abbyfinka/FYP-Knitted-EMG/Hardware/Programming PCB/SCH_Prog_2026-05-19.pdf

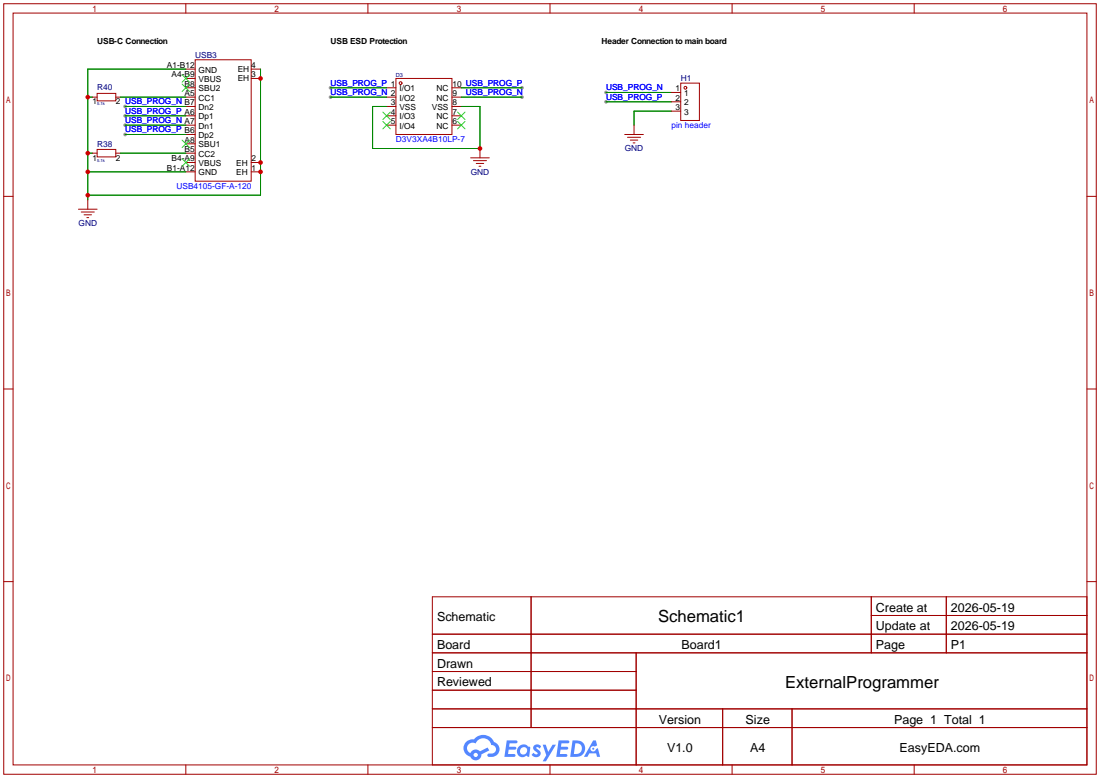
[picture p6: page 1]

Header Connection to main board

Schematic | Schematic1 | Create at | 2026-05-19

Update at | 2026-05-19

Board | Board1 | Page | P1
Drawn | | ExternalProgrammer
Reviewed

Version | Size | Page 1 Total 1
V1.0 | A4 | EasyEDA.com
