abbyfinka/FYP-Knitted-EMG/Hardware/Rigid Redesign/SCH_Schematic1_2026-06-12.pdf

IO48 30 IO35 31 IO36 32 IO37 33 IO38 34 IO39 35 IO40 36 IO41 37 IO42 38 TXD0 39 RXD0 40 IO45 41 GND 42 GND 43 IO46 44 EN 45 GND 46 GND 47 GND 48 GND 49 GND 50 GND 51 GND 52 GND 53 GND 54 GND 55 GND 56 GND 57 GND 58 GND 59 GND 60 GND

# IN1P 16 WCT 64 TESTP_PACE_OUT1 17 RLDOUT 63 TESTN_PACE_OUT2 18

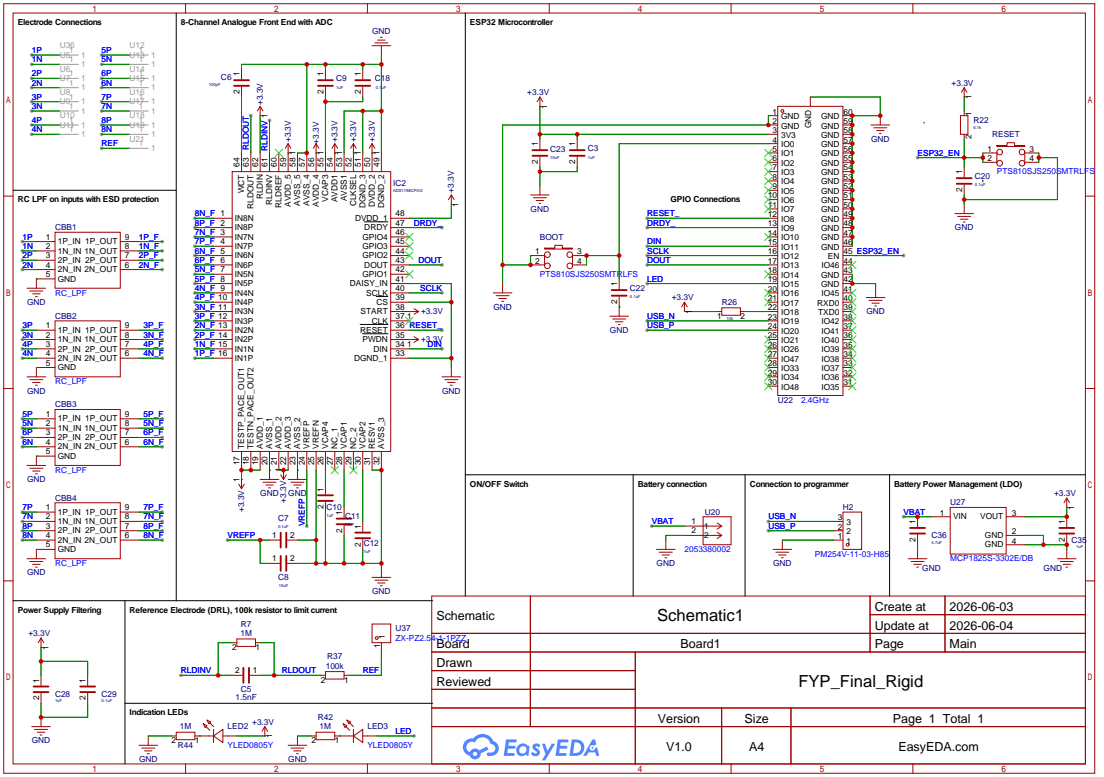
[picture p7: page 1]

8-Channel Analogue Front End with ADC

RC LPF on inputs with ESD protection

Schematic | Schematic1 | Create at | 2026-06-03

Update at | 2026-06-04

Drawn | FYP_Final_Rigid
Reviewed

Version | Size | Page 1 Total 1
V1.0 | A4 | EasyEDA.com

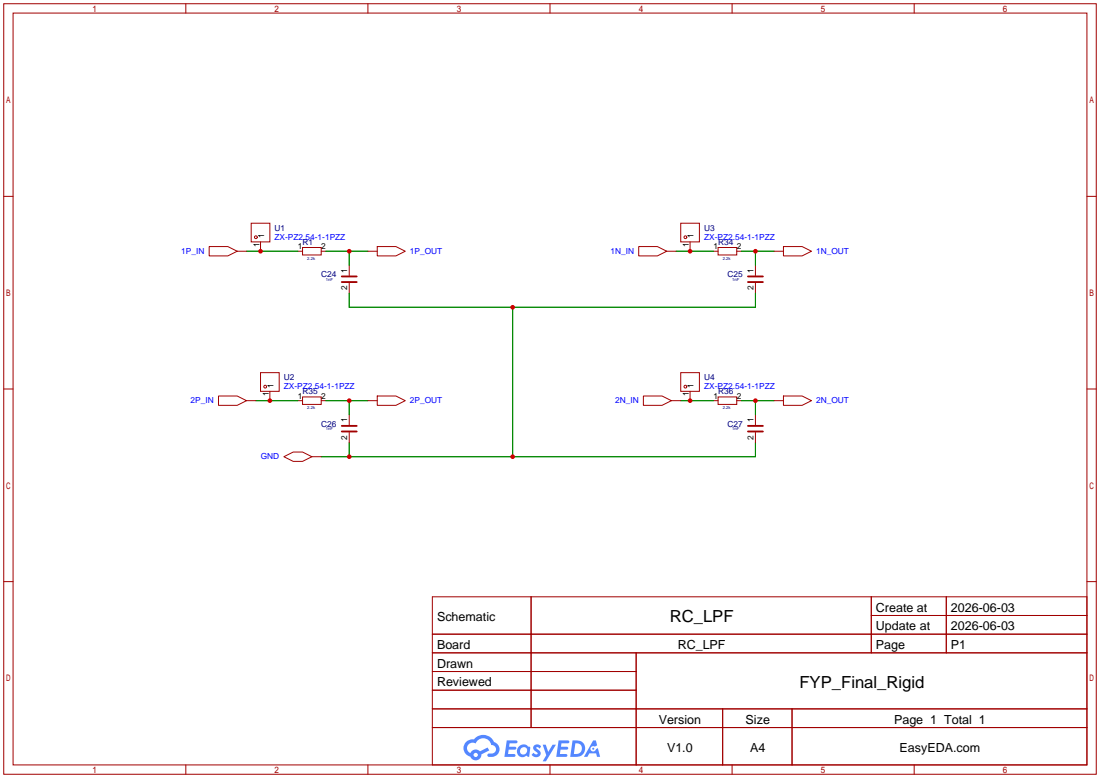
[picture p8: page 2]

Schematic | RC_LPF | Create at | 2026-06-03

Update at | 2026-06-03

Board | RC_LPF | Page | P1
Drawn | | FYP_Final_Rigid
Reviewed

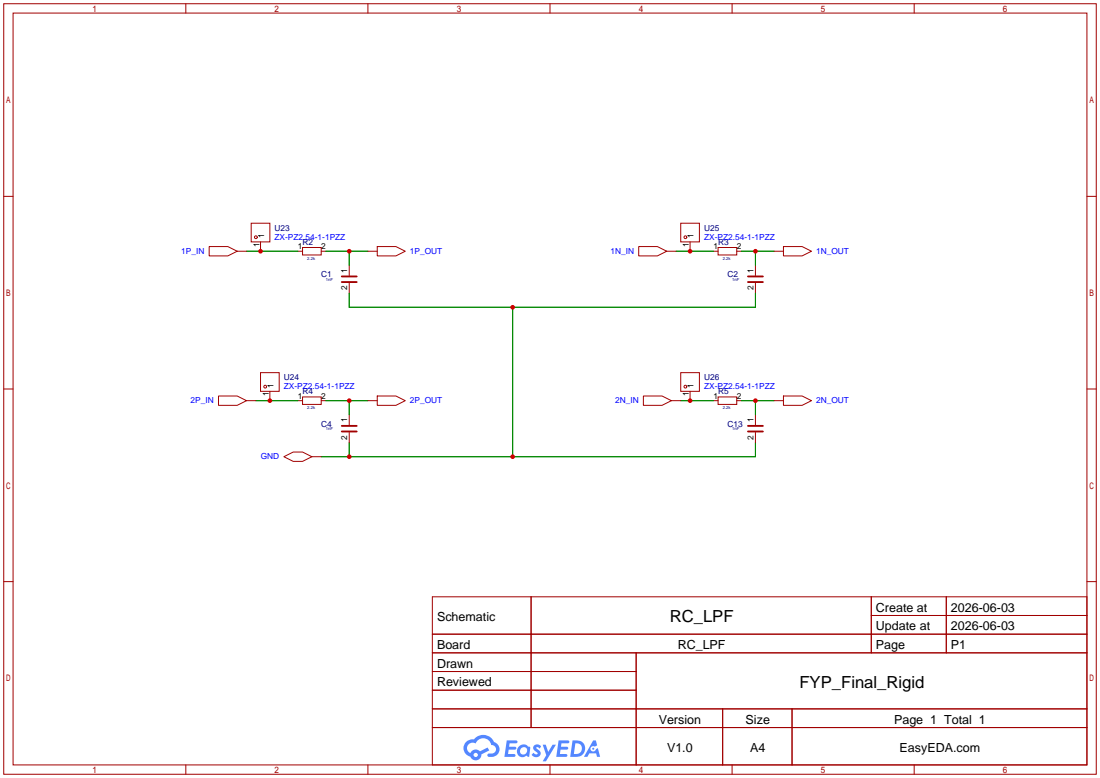
[picture p9: page 3]

Schematic | RC_LPF | Create at | 2026-06-03

Update at | 2026-06-03

Board | RC_LPF | Page | P1
Drawn | | FYP_Final_Rigid
Reviewed

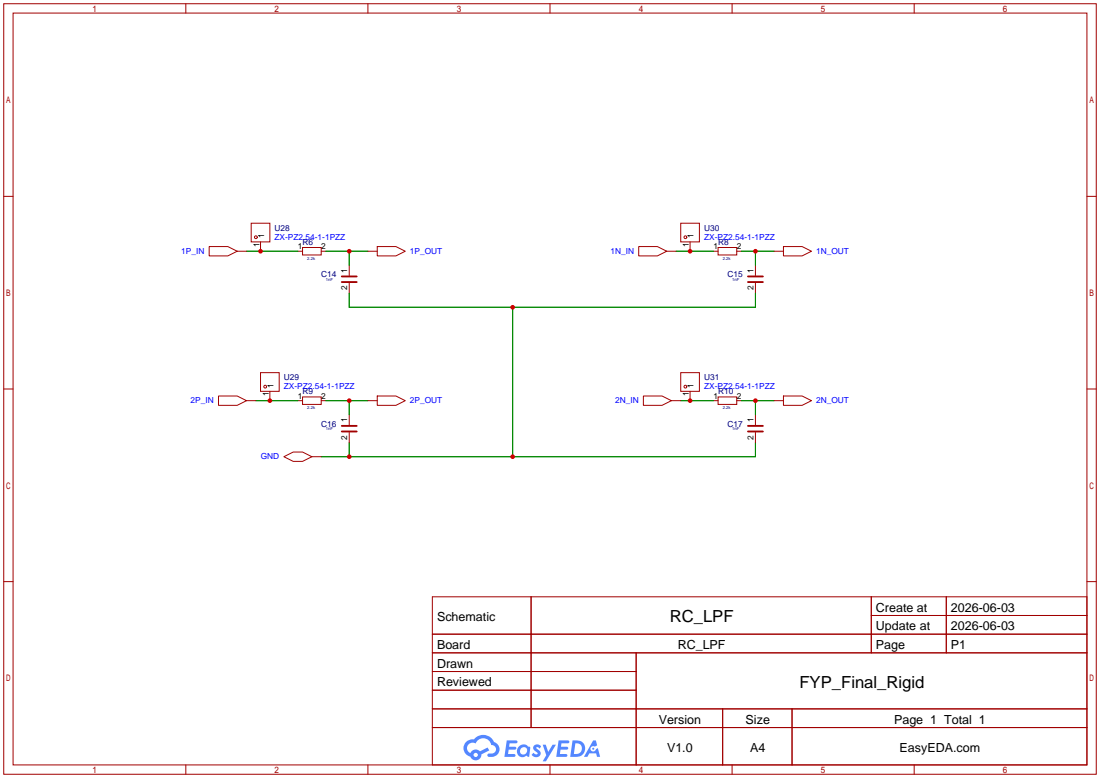
[picture p10: page 4]

Schematic | RC_LPF | Create at | 2026-06-03

Update at | 2026-06-03

Board | RC_LPF | Page | P1
Drawn | | FYP_Final_Rigid
Reviewed

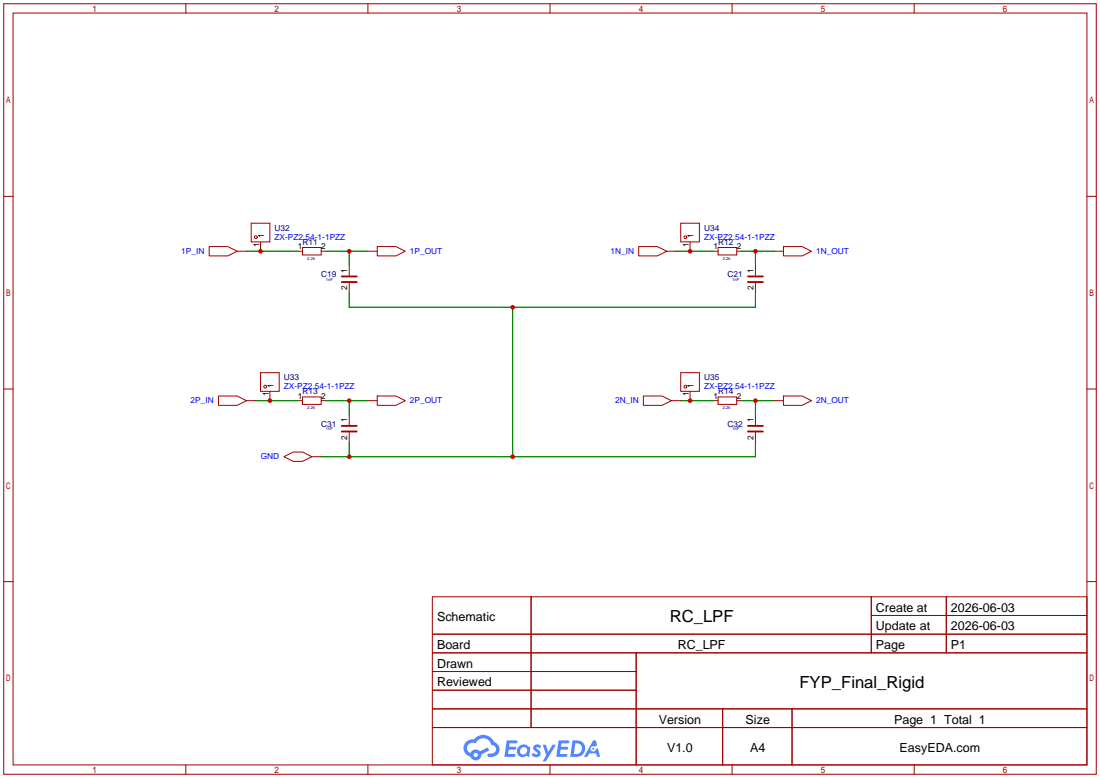
[picture p11: page 5]

Schematic | RC_LPF | Create at | 2026-06-03

Update at | 2026-06-03

Board | RC_LPF | Page | P1
Drawn | | FYP_Final_Rigid
Reviewed
