abbyfinka/FYP-Knitted-EMG/Hardware/Test PCB/schematic.pdf

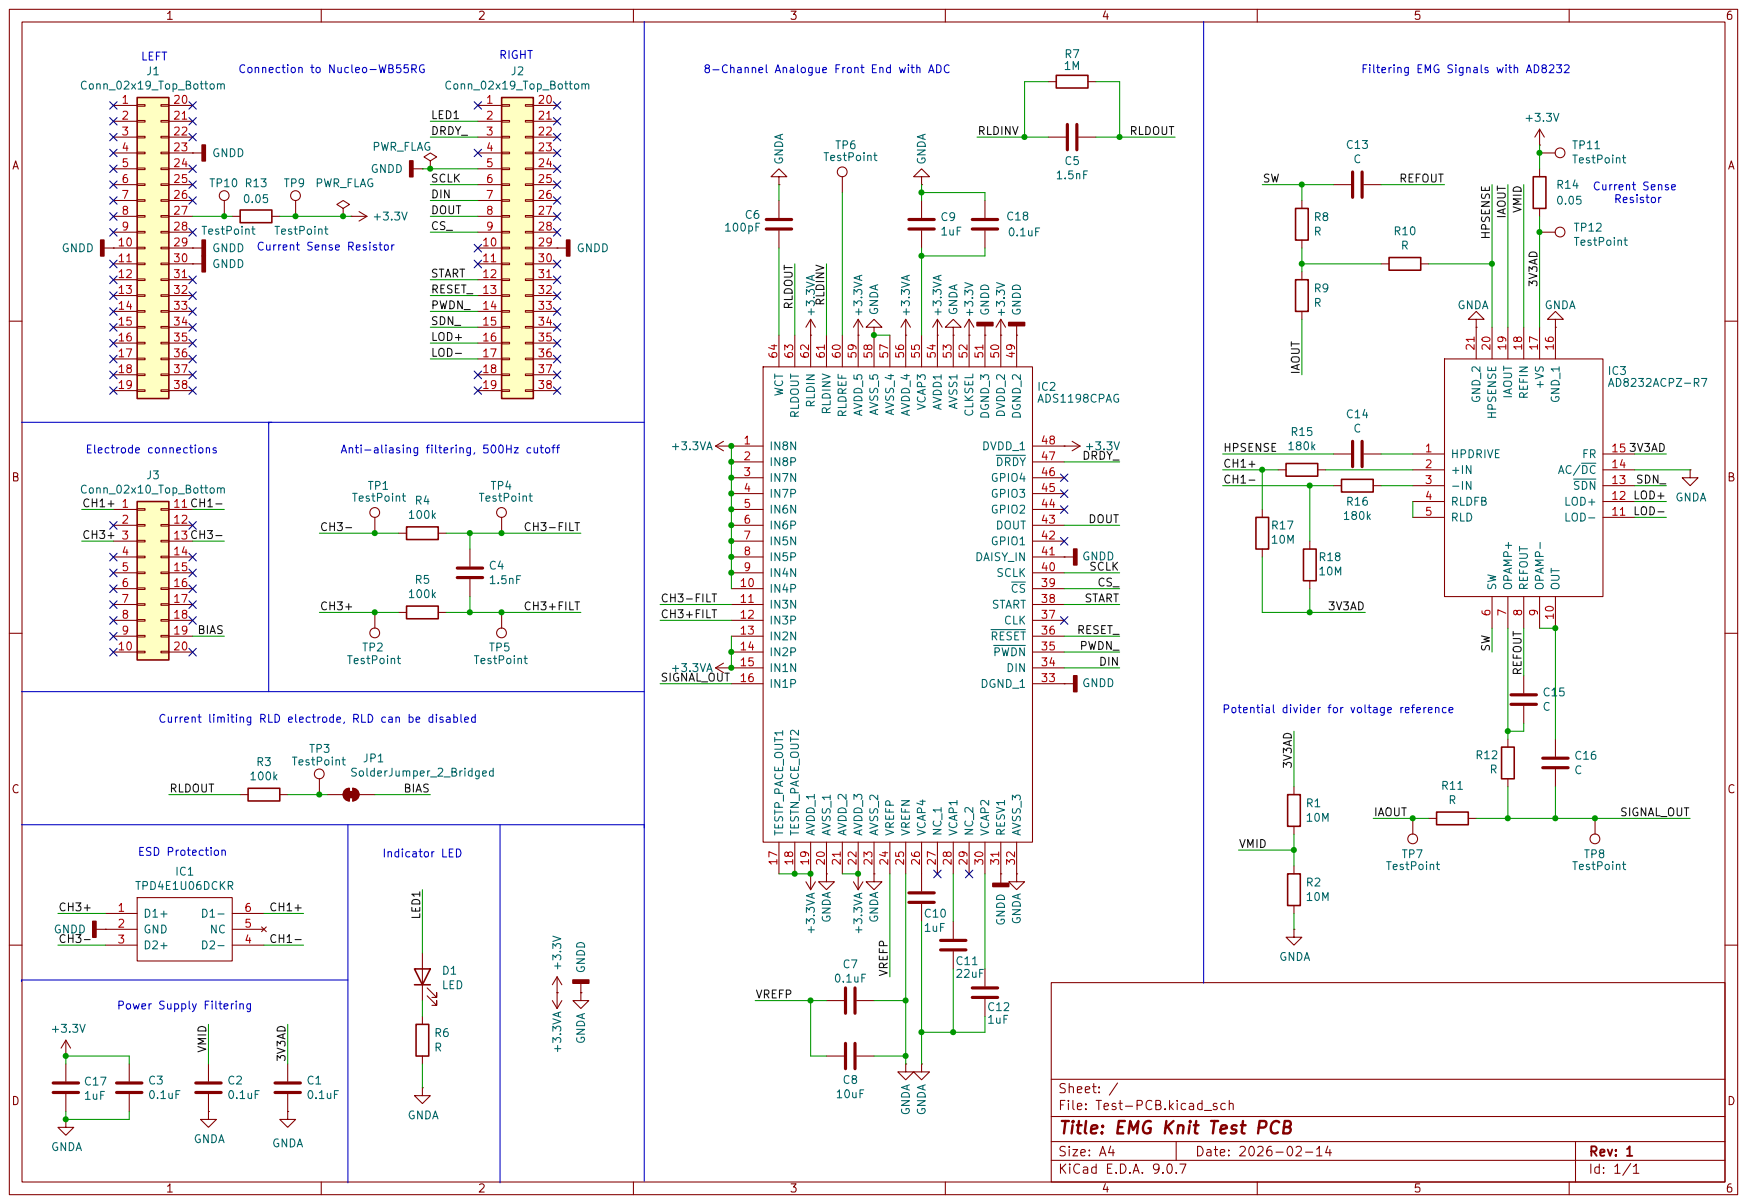
[picture p12: page 1]
