abbyfinka/FYP-Knitted-EMG/(list of files, drawings)

Other design files:
Hardware/Flexible PCB/ProPrj_FYP_Flexible_PCB_Final.epro
Hardware/Programming PCB/ProPrj_ExternalProgrammer.epro
Hardware/Rigid Redesign/ProPrj_FYP_Final_Rigid.epro
