abbyfinka/FYP-Knitted-EMG/Hardware/Test PCB/Test-PCB.kicad_pcb

## KiCad design Hardware/Test PCB/Test-PCB.kicad_pcb (2026-06-12)

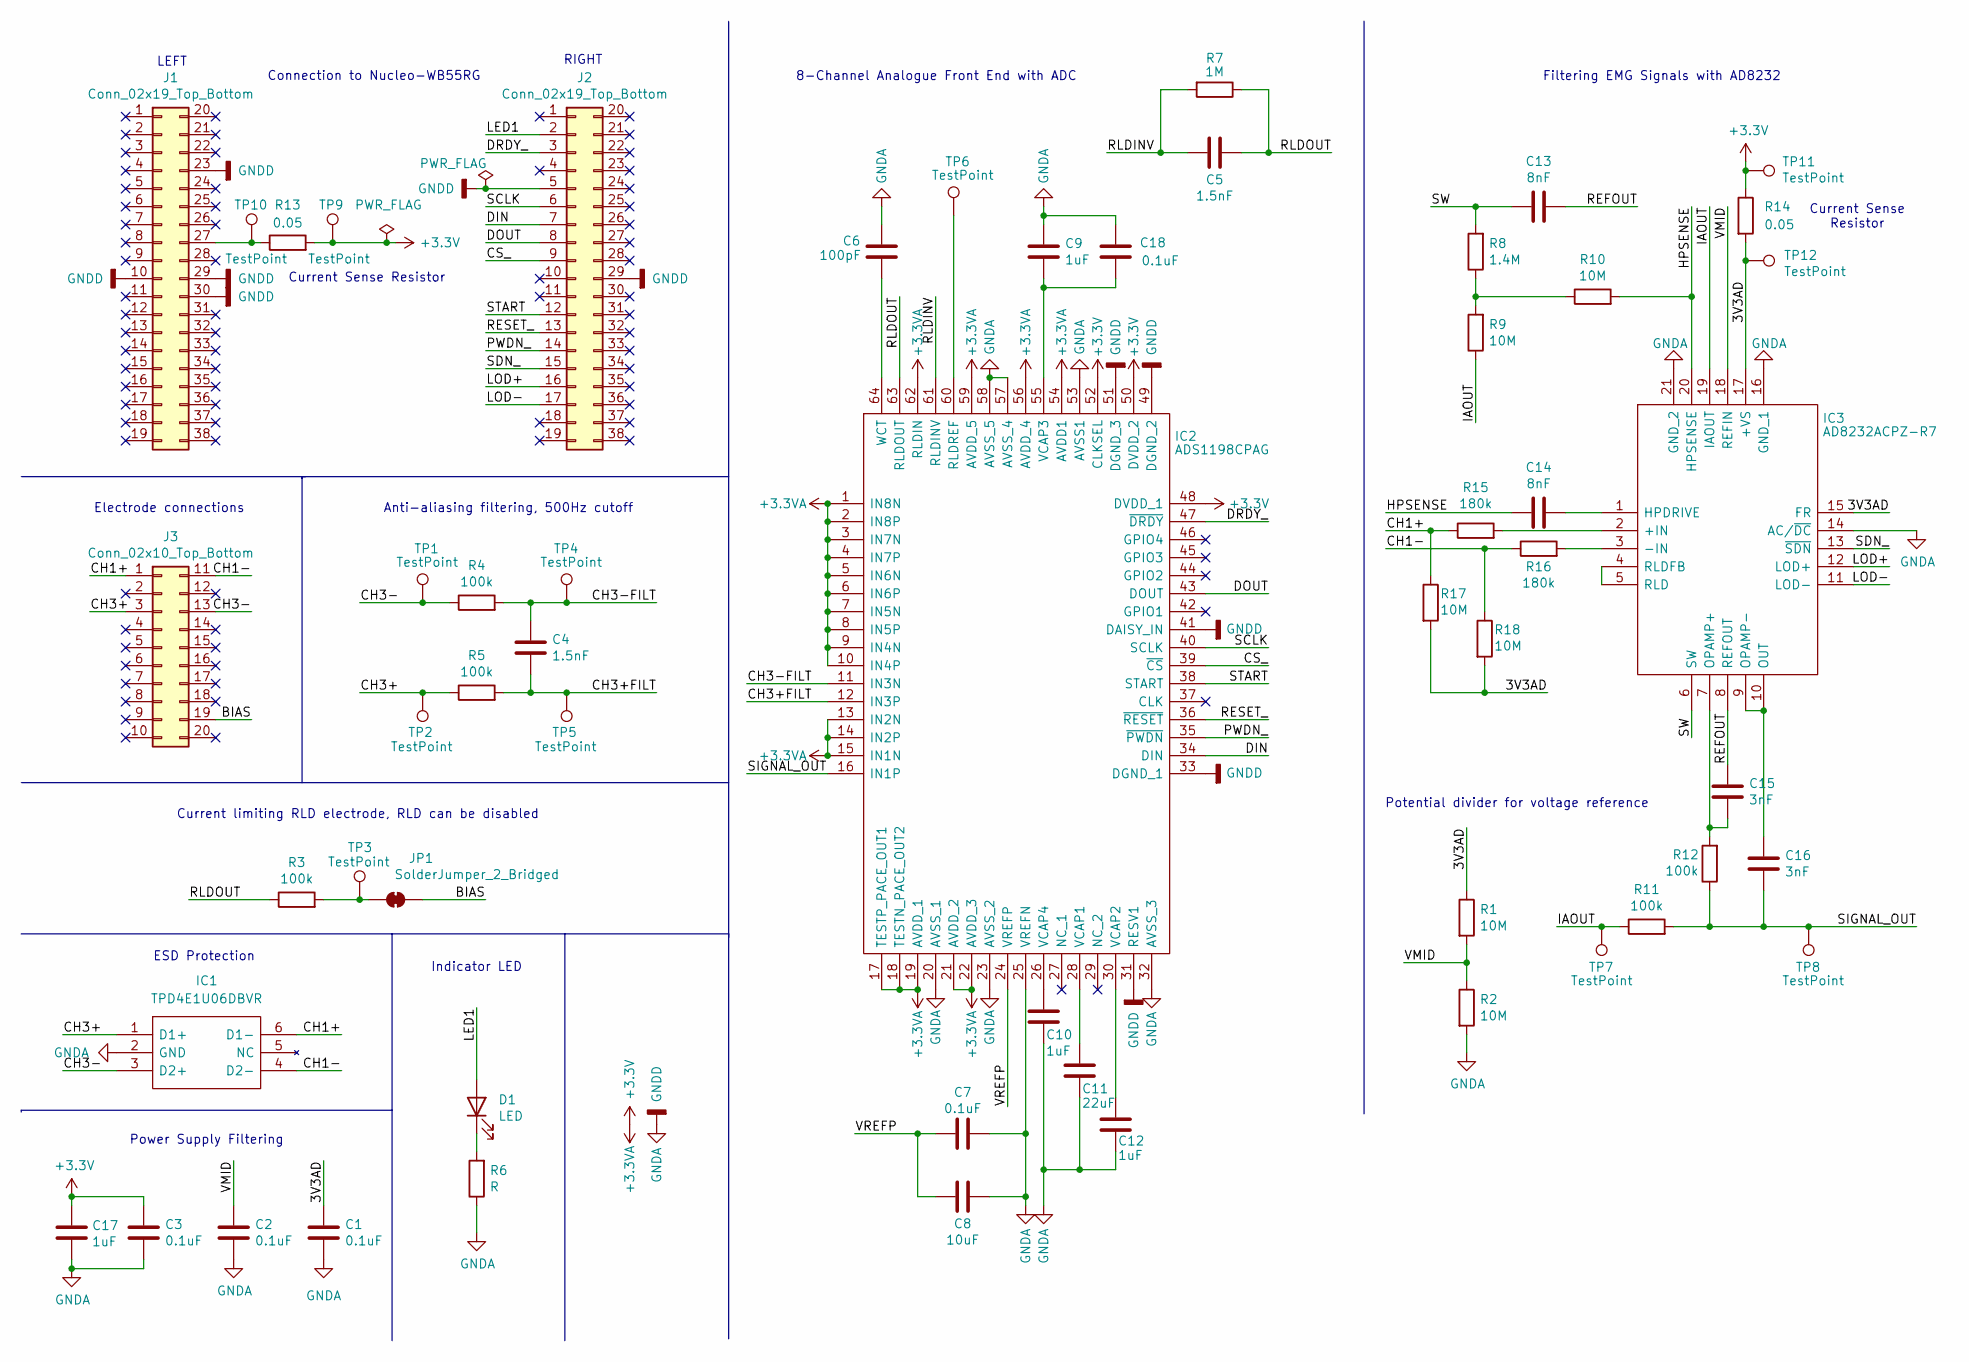
[picture p13: schematic Test-PCB.kicad_sch, EMG Knit Test PCB]

Parts:
C1, C2, C3, C7, C18: 0.1uF; C_0805_2012Metric
C4, C5: 1.5nF; C_0805_2012Metric
C6: 100pF; C_0805_2012Metric
C8: 10uF; C_0805_2012Metric
C9, C10, C12, C17: 1uF; C_0805_2012Metric
C11: 22uF; C_0805_2012Metric
C13, C14: 8nF; C_0805_2012Metric
C15, C16: 3nF; C_0805_2012Metric
D1: LED; LED_0805_2012Metric
IC1: TPD4E1U06DBVR; SOT95P280X145-6N; Manufacturer_Part_Number TPD4E1U06DBVR
IC2: ADS1198CPAG; QFP50P1200X1200X120-64N; Mouser Part Number 595-ADS1198CPAG
IC3: AD8232ACPZ-R7; QFN50P400X400X80-21N-D; Manufacturer_Part_Number AD8232ACPZ-R7; Mouser Part Number 584-AD8232ACPZ-R7
J1, J2: Conn_02x19_Top_Bottom; PinHeader_2x19_P2.54mm_Vertical_Top_Bottom
J3: Conn_02x10_Top_Bottom; PinHeader_2x10_P2.54mm_Horizontal_Top_Bottom
JP1: SolderJumper_2_Bridged; SolderJumper-2_P1.3mm_Bridged_RoundedPad1.0x1.5mm
R1, R2, R9, R10, R17, R18: 10M; R_0805_2012Metric
R3, R4, R5, R11, R12: 100k; R_0805_2012Metric
R6: R; R_0805_2012Metric
R7: 1M; R_0805_2012Metric
R8: 1.4M; R_0805_2012Metric
R13, R14: 0.05; R_0805_2012Metric
R15, R16: 180k; R_0805_2012Metric
TP1, TP2, TP3, TP4, TP5, TP6, TP7, TP8, TP9, TP10, TP11, TP12: TestPoint; TestPoint_Pad_D2.0mm

Connections:
+3.3V: C3.1, C17.1, IC2.1 (IN8N), IC2.2 (IN8P), IC2.3 (IN7N), IC2.4 (IN7P), IC2.5 (IN6N), IC2.6 (IN6P), IC2.7 (IN5N), IC2.8 (IN5P), IC2.9 (IN4N), IC2.10 (IN4P), IC2.13 (IN2N), IC2.14 (IN2P), IC2.15 (IN1N), IC2.17 (TESTP_PACE_OUT1), IC2.18 (TESTN_PACE_OUT2), IC2.19 (AVDD_1), IC2.21 (AVDD_2), IC2.22 (AVDD_3), IC2.48 (DVDD_1), IC2.50 (DVDD_2), IC2.52 (CLKSEL), IC2.54 (AVDD1), IC2.56 (AVDD_4), IC2.59 (AVDD_5), IC2.62 (RLDIN), R13.2, R14.1, TP9.1, TP11.1
/3V3AD: C1.1, IC3.15 (FR), IC3.17 (+VS), R1.1, R14.2, R17.2, R18.2, TP12.1
/BIAS: J3.19, JP1.2 (B)
/CH1+: IC1.6 (D1-), J3.1, R15.1, R17.1
/CH1-: IC1.4 (D2-), J3.11, R16.1, R18.1
/CH3+: IC1.1 (D1+), J3.3, R5.1, TP2.1
/CH3+FILT: C4.2, IC2.12 (IN3P), R5.2, TP5.1
/CH3-: IC1.3 (D2+), J3.13, R4.1, TP1.1
/CH3-FILT: C4.1, IC2.11 (IN3N), R4.2, TP4.1
/CS_: IC2.39 (~CS), J2.9
/DIN: IC2.34 (DIN), J2.7
/DOUT: IC2.43 (DOUT), J2.8
/DRDY_: IC2.47 (~DRDY), J2.3
/HPSENSE: C14.2, IC3.20 (HPSENSE), R10.2
/IAOUT: IC3.19 (IAOUT), R9.1, R11.1, TP7.1
/LED1: D1.2 (A), J2.2
/LOD+: IC3.12 (LOD+), J2.16
/LOD-: IC3.11 (LOD-), J2.17
/PWDN_: IC2.35 (~PWDN), J2.14
/REFOUT: C13.1, C15.2, IC3.8 (REFOUT)
/RESET_: IC2.36 (~RESET), J2.13
/RLDINV: C5.2, IC2.61 (RLDINV), R7.2
/RLDOUT: C5.1, IC2.63 (RLDOUT), R3.1, R7.1
/SCLK: IC2.40 (SCLK), J2.6
/SDN_: IC3.13 (~SDN), J2.15
/SIGNAL_OUT: C16.1, IC2.16 (IN1P), R11.2, R12.1, TP8.1
/START: IC2.38 (START), J2.12
/SW: C13.2, IC3.6 (SW), R8.2
/VMID: C2.1, IC3.18 (REFIN), R1.2, R2.1
/VREFP: C7.1, C8.1, IC2.24 (VREFP)
GNDA: C1.2, C2.2, C3.2, C6.1, C7.2, C8.2, C9.1, C10.2, C11.2, C12.2, C17.2, C18.1, IC1.2 (GND), IC2.20 (AVSS_1), IC2.23 (AVSS_2), IC2.25 (VREFN), IC2.31 (RESV1), IC2.32 (AVSS_3), IC2.33 (DGND_1), IC2.41 (DAISY_IN), IC2.49 (DGND_2), IC2.51 (DGND_3), IC2.53 (AVSS1), IC2.57 (AVSS_4), IC2.58 (AVSS_5), IC3.14 (AC/~DC), IC3.16 (GND_1), IC3.21 (GND_2), J1.10, J1.23, J1.29, J1.30, J2.5, J2.29, R2.2, R6.1
unnamed: D1.1 (K), R6.2
unnamed: IC2.60 (RLDREF), TP6.1
unnamed: C11.1, IC2.28 (VCAP1)
unnamed: C12.1, IC2.30 (VCAP2)
unnamed: C9.2, C18.2, IC2.55 (VCAP3)
unnamed: C10.1, IC2.26 (VCAP4)
unnamed: C6.2, IC2.64 (WCT)
unnamed: IC3.2 (+IN), R15.2
unnamed: IC3.3 (-IN), R16.2
unnamed: C14.1, IC3.1 (HPDRIVE)
unnamed: C15.1, IC3.7 (OPAMP+), R12.2
unnamed: C16.2, IC3.9 (OPAMP-), IC3.10 (OUT)
unnamed: IC3.4 (RLDFB), IC3.5 (RLD)
unnamed: J1.27, R13.1, TP10.1
unnamed: JP1.1 (A), R3.2, TP3.1
unnamed: R8.1, R9.2, R10.1

Notes on the sheet:
RIGHT
Current limiting RLD electrode, RLD can be disabled
Potential divider for voltage reference
Current Sense Resistor
Electrode connections
Indicator LED
LEFT
Connection to Nucleo-WB55RG
Anti-aliasing filtering, 500Hz cutoff
Current Sense Resistor
ESD Protection
Filtering EMG Signals with AD8232
Power Supply Filtering
8-Channel Analogue Front End with ADC

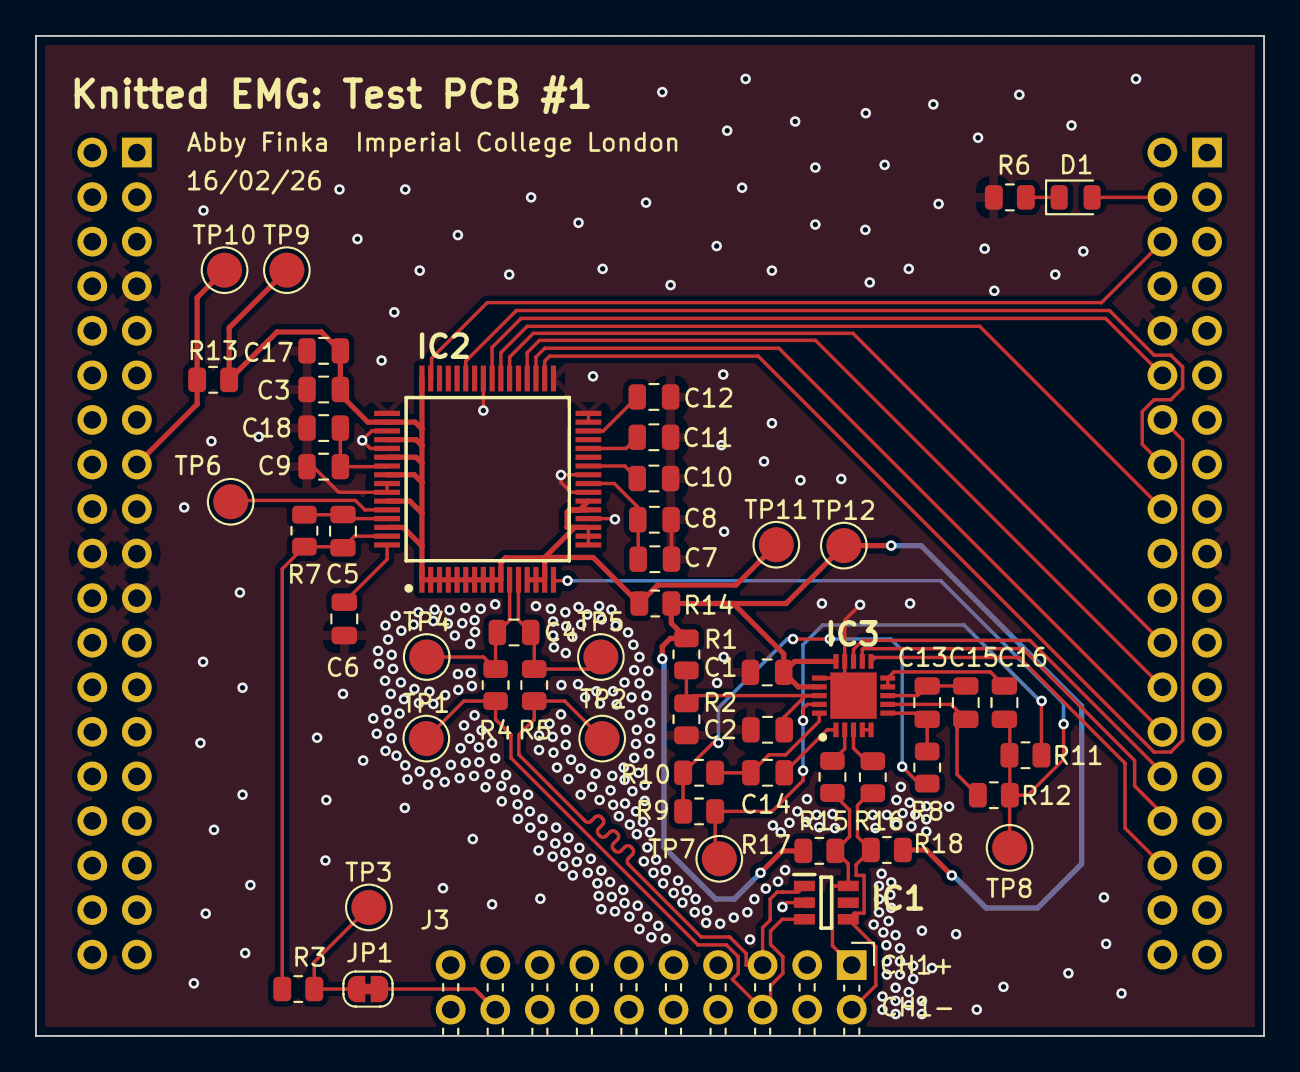
[picture p14: board Test-PCB.kicad_pcb from above]

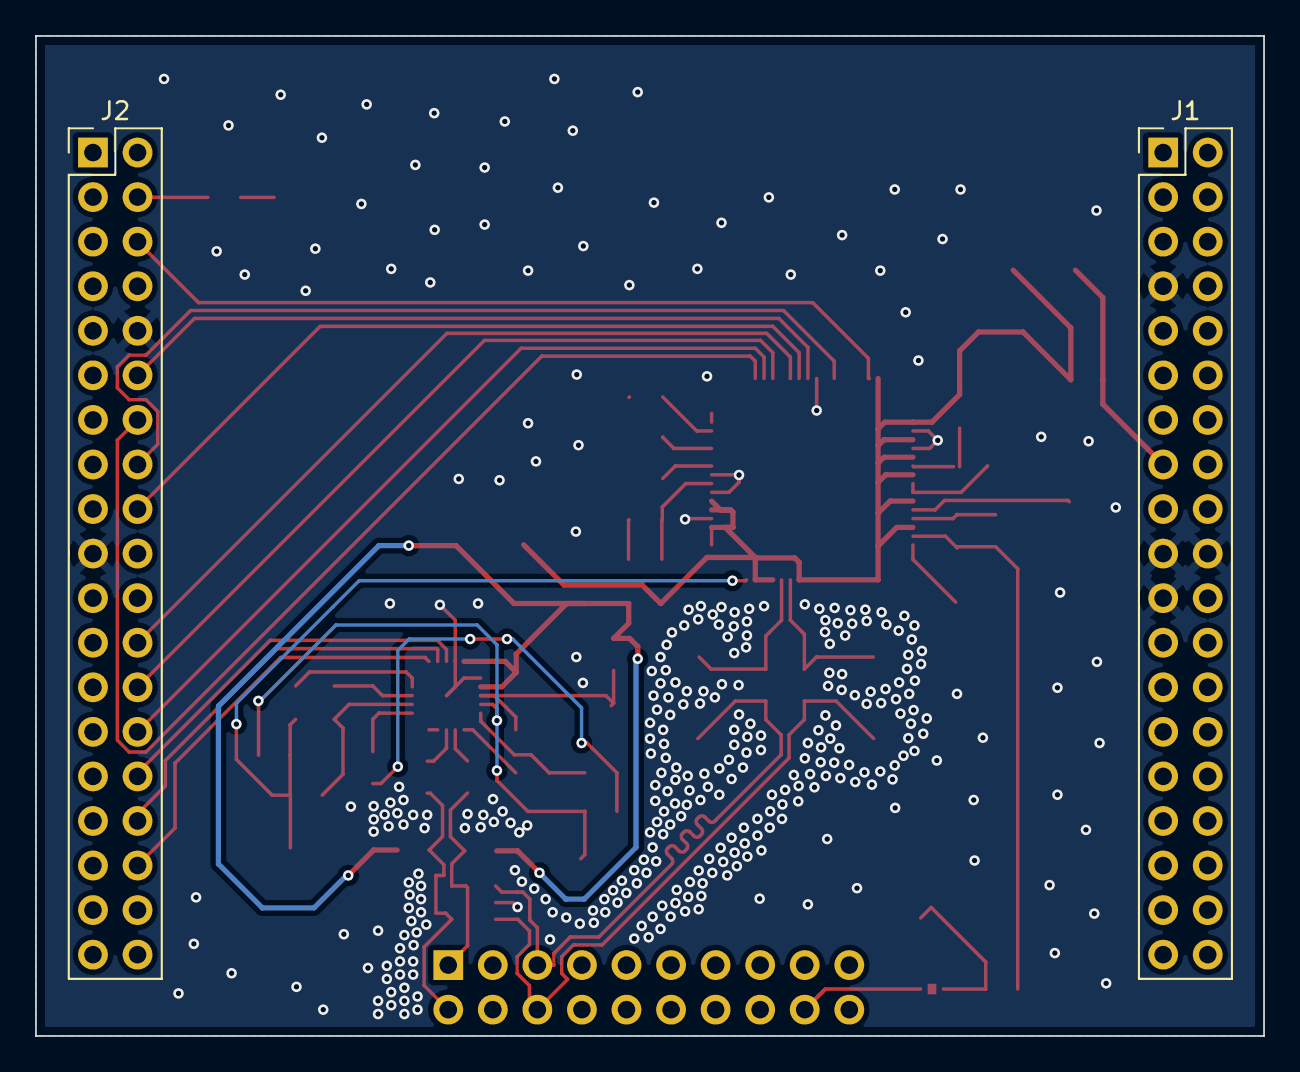
[picture p15: board Test-PCB.kicad_pcb from below]

Board: 2 copper layers, 70.0 x 57.0 mm, 56 parts (2 on the bottom side), 47 nets.
