abbyfinka/FYP-Knitted-EMG/(commit log)

2026-03-10 SPI over hardware interrupt
2026-03-10 SPI over task notifications
2026-04-27 1000Hz sampling, notch not working, bandpass filtering in python
    [main.cpp]
2026-04-29 gain normalisation, notch filter not completely working
2026-05-25 use arduino filters for ema
2026-05-25 eight filters
2026-05-26 update EMA filter
2026-06-12 Add hardware and classification files
    [ProPrj_ExternalProgrammer.epro, ProPrj_FYP_Final_Rigid.epro, ProPrj_FYP_Flexible_PCB_Final.epro, Test-PCB.kicad_pcb, Test-PCB.kicad_sch]
2026-06-21 Add device guide
2026-06-22 changes for esp on pcb
